tcballard/grokbot-physical/src/lib.rs

//! Runtime and compatibility contracts for the Hey Grok Bot Orb.
pub mod audio;
pub mod bots;
pub mod config;
pub mod daemon;
pub mod halo;
pub mod protocol;
pub mod realtime;
pub mod speak;
pub mod tts;
pub mod wakeword;
pub mod webhook;
